bschulz1701/Project-Palmer/README.md

# Project-Palmer
Multiple system designs for golf course turf monitoring project
