bschulz1701/Project-Palmer/Documentation/2019-10-11_Project_Palmer_RectifierDesign.pdf

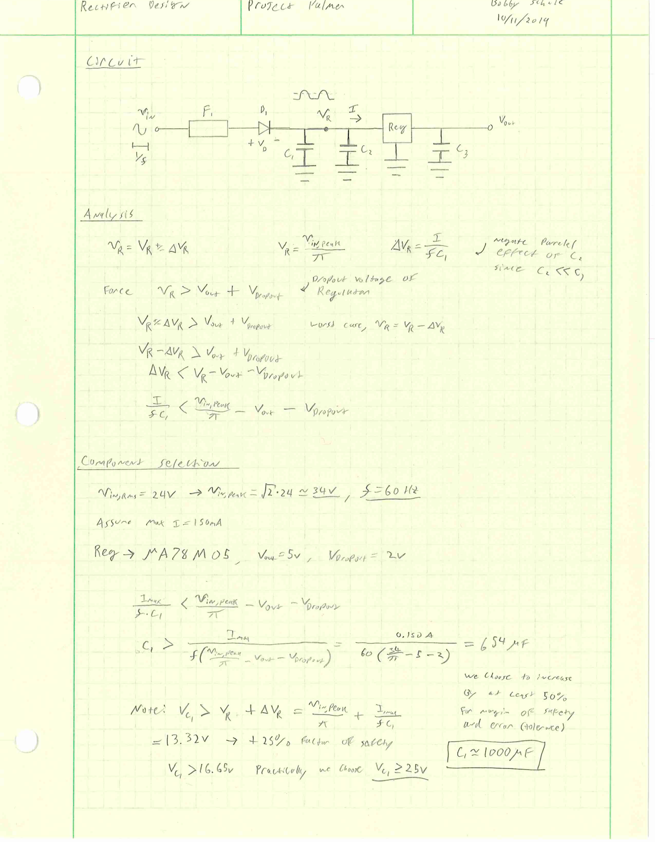
[picture p1: page 1]
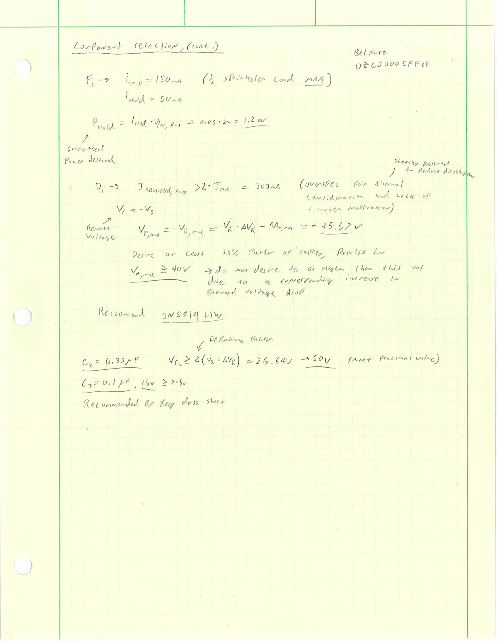
[picture p2: page 2]
