bschulz1701/Project-Palmer/Documentation/BSFrance_LoRa_32u4_Dimensions_UPDATED.pdf

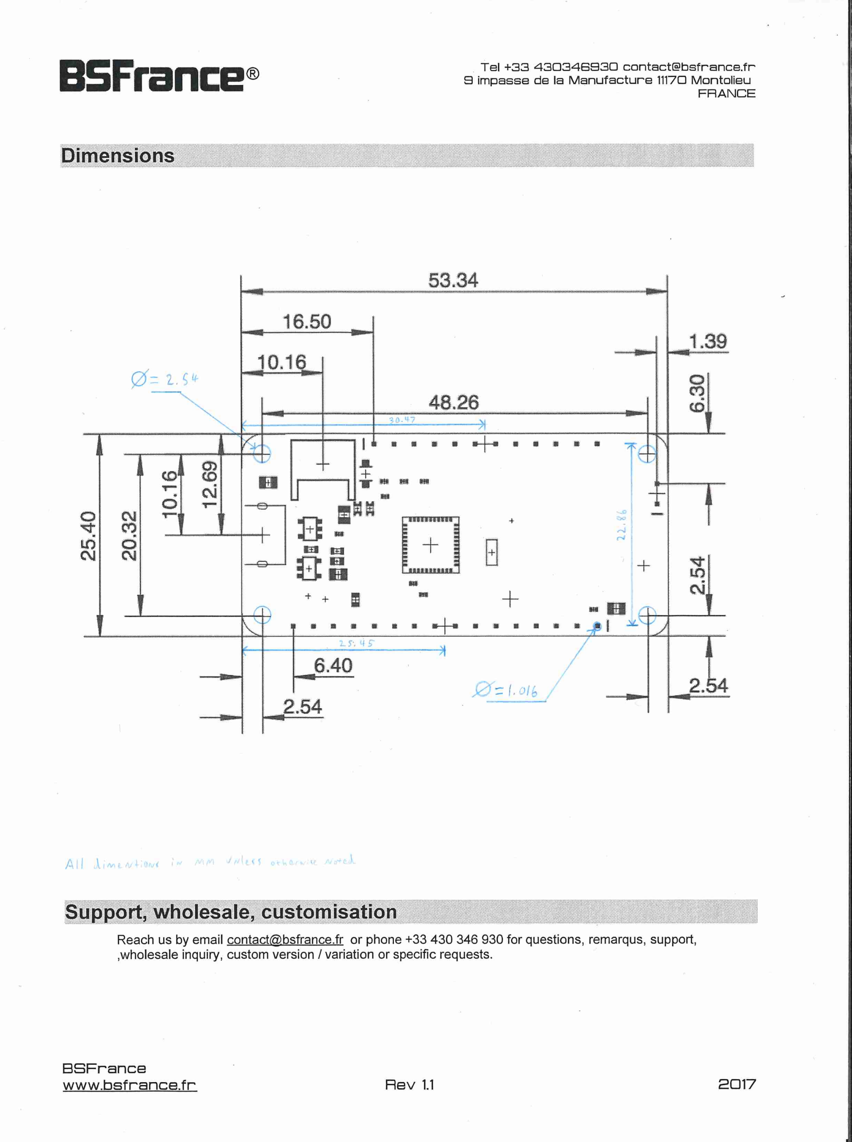
[picture p3: page 1]
