bschulz1701/Project-Palmer/Mechanical/SoilMoistureProbeHolder.SLDPRT

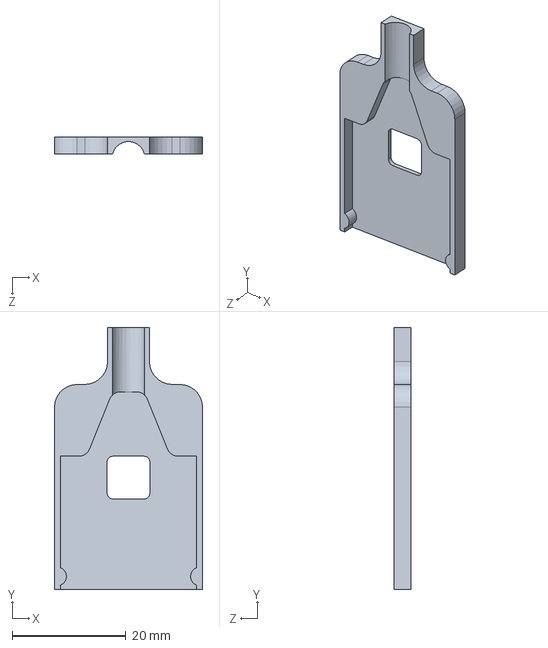
[picture p4: CAD file, 2020-04-01]
Mechanical/SoilMoistureProbeHolder.SLDPRT
26.0 x 46.0 x 3.00 mm
