bschulz1701/Project-Palmer/(list of files, cad)

Other CAD files:
Mechanical/SoilMoistureProbeHolder.STL
