bschulz1701/Project-Palmer/(threads)

Thread 1 (2019-11-12):

Change ADC Choice/Topology

bschulz1701, 2019-11-12:
## Issue:
- ADCs were placed improperly with respect to the Primary and Remote boards (they should be switched)
- MCP3221 does not have an internal reference, so should have an external reference or a tightly controlled 3.3v input rail

## Proposed Solution:
- Change ADC placement
**Correct:**
MCP3421 -> Remote Board
MCP3221 -> Primary Board
- Add voltage reference to MCP3221 circuit

### Progress:
- [ ] Change ADC arrangement
- [ ] Choose voltage reference for MCP3221
- [ ] Design circuit and implement for MCP3221

bschulz1701, 2019-11-20:
Additional design note:
Ensure ADC used on Primary Board has range up to Vcc (3.3v). **v0.0** version of system has MCP3421 on Primary Board, which has range _only up to +2.048v_, where as potential range for soil moisture sensors is up to _+Vcc (+3.3v)_. So when using the MCP3221 (with external reference) on **v0.1**, make sure external reference can allow up to +Vcc measurement.

Similarly, in **v0.1** of Remote Board, make sure the gain range of O2 amp does not exceed +2.048v

Thread 2 (2019-11-13):

Add Reset pullup

bschulz1701, 2019-11-13:
## Issue:
No pullup on `RESET` line on Primary Board, this results in problems configuring MCP23008 IO expander when no external pullup is applied (as would be the case when a LoRa 32u4 board is plugged into the corresponding socket). While this is likely to be the general operating case, it is desired to have the most flexible design possible.

## Proposed Solution:
Add 10k&Omega; pullup resistor on line

Thread 3 (2019-11-13):

PRIMARY - Add OneWire pullup

bschulz1701, 2019-11-13:
## Issue:
OneWire line needs to have a strong pull-up to work properly, which exceeds the internal pull-up available on the MCP23008 (100k&Omega;). This results in communication errors using the OneWire bus

## Proposed Solution:
Add 4.7k&Omega; pull-up to the global `ONEWIRE` line, this prevents the need for individual sensor pull-ups since this line will be connected to each via MUX when communicating

Thread 4 (2020-02-13):

REMOTE - Test TCS3400 functionality

bschulz1701, 2020-02-13:
## Issue:
TCS3400 documentation lists a minimum operating voltage of 2.7V, however, in the remote board configuration it is being run at 1.8V.

## Potential solution:
Test functionality of TCS3400 in current state (to determine validity of data), then switch system to operate at 3.3V level. Review signal routing topology to ensure desired network functionality.
