bschulz1701/Project-Palmer/Hardware/PrimaryBoard.brd

## EAGLE design Hardware/PrimaryBoard.brd (2019-10-25)

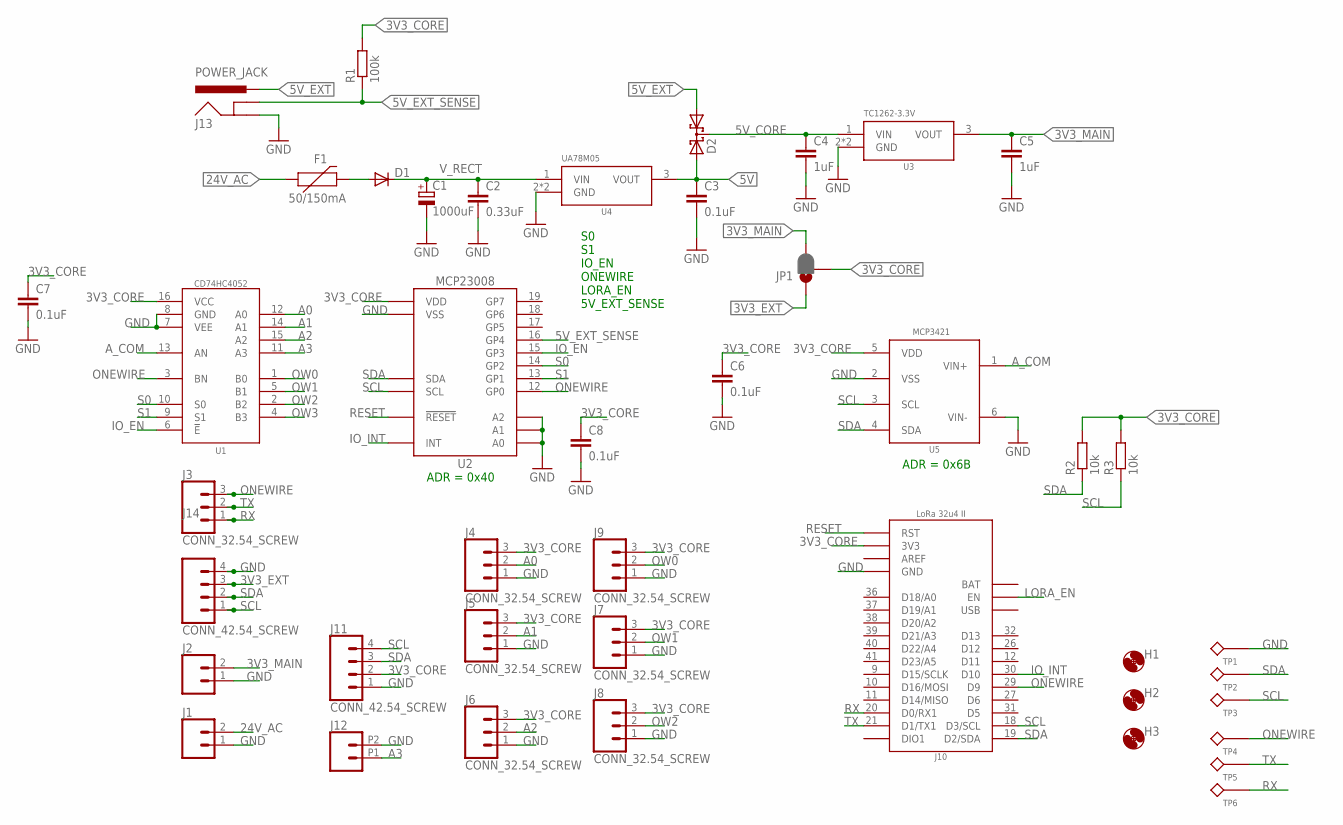
[picture p6: schematic PrimaryBoard.sch]

Parts:
C1: 1000uF; PANASONIC_G; MPN EEE-FT1E102UP; DIGIKEY P122428CT-ND
C2: 0.33uF; C0805
C3, C6, C7, C8: 0.1uF; C0805
C4, C5: 1uF; C0805
D1: DIODESOD-123; SOD-123; MPN 1N5819HW-7-F; DIGIKEY 1N5819HW-FDICT-ND
D2: DIODE_CCSDM40E20LCSOT23; SOT23-3
F1: 50/150mA; 1206
H1, H2, H3: MOUNTING_HOLE2_NP; 2_56
J1: CONN_0239532_RA; 1X02_39532_RIGHT
J2: CONN_023.5MM-NO_SILK; SCREWTERMINAL-3.5MM-2-NS
J3, J4, J5, J6, J7, J8, J9: CONN_32.54_SCREW; 1X03_SCREW
J10: LORA32U4II
J11, J14: CONN_42.54_SCREW; 1X04_SCREW
J12: CONN_022.54_SCREW; 1X02_2.54_SCREWTERM
J13: POWER_JACK; POWER_JACK_PTH
JP1: JUMPER-SMT_3_1-NC_PASTE_SILK; SMT-JUMPER_3_1-NC_PASTE_SILK
R1: 100k; R0805
R2, R3: 10k; R0805
TP1, TP2, TP3, TP4, TP5, TP6: TESTPOINTRCU; TESTPOINT_0603
U1: CD74HC4052PW; TSSOP16
U2: MCP23008SSOP; SSOP20
U3: TC1262-3.3V; SOT223
U4: UA78M05SOT223; SOT223
U5: MCP3421A3; SOT23-6L

Connections:
3V3_CORE: C6.1, C7.1, C8.1, J4.3, J5.3, J6.3, J7.3, J8.3, J9.3, J10.3V3, J11.2, JP1.2, R1.2, R2.2, R3.2, U1.16 (VCC), U2.20 (VDD), U5.5 (VDD)
3V3_EXT: J14.3, JP1.1
3V3_MAIN: C5.1, J2.2, JP1.3, U3.3 (VOUT)
5V: C3.1, D2.2 (A2), U4.3 (VOUT)
5V_CORE: C4.1, D2.3 (C), U3.1 (VIN)
5V_EXT: D2.1 (A1), J13.PWR
5V_EXT_SENSE: J13.GNDBREAK, R1.1, U2.16 (GP4)
24V_AC: F1.1, J1.2
A0: J4.2, U1.12 (A0)
A1: J5.2, U1.14 (A1)
A2: J6.2, U1.15 (A2)
A3: J12.P1 (1), U1.11 (A3)
A_COM: U1.13 (AN), U5.1 (VIN+)
BAT: J10.BAT
GND: C1.-, C2.2, C3.2, C4.2, C5.2, C6.2, C7.2, C8.2, J1.1, J2.1, J4.1, J5.1, J6.1, J7.1, J8.1, J9.1, J10.GND, J11.1, J12.P2 (2), J13.GND, J14.4, TP1.1, U1.7 (VEE), U1.8 (GND), U2.3 (A2), U2.4 (A1), U2.5 (A0), U2.9 (VSS), U3.2 (GND), U3.4 (GND), U4.2 (GND), U4.4 (GND), U5.2 (VSS), U5.6 (VIN-)
IO_EN: U1.6 (!E), U2.15 (GP3)
IO_INT: J10.30 (D10), U2.8 (INT)
LORA_EN: J10.EN
unnamed: D1.ANODE (A), F1.2
ONEWIRE: J3.3, J10.29 (D9), TP4.1, U1.3 (BN), U2.12 (GP0)
OW0: J9.2, U1.1 (B0)
OW1: J7.2, U1.5 (B1)
OW2: J8.2, U1.2 (B2)
OW3: U1.4 (B3)
RESET: J10.RST, U2.6 (!RESET)
RX: J3.1, J10.20 (D0/RX1), TP6.1
S0: U1.10 (S0), U2.14 (GP2)
S1: U1.9 (S1), U2.13 (GP1)
SCL: J10.18 (D3/SCL), J11.4, J14.1, R3.1, TP3.1, U2.1 (SCL), U5.3 (SCL)
SDA: J10.19 (D2/SDA), J11.3, J14.2, R2.1, TP2.1, U2.2 (SDA), U5.4 (SDA)
TX: J3.2, J10.21 (D1/TX1), TP5.1
USB: J10.USB
V_RECT: C1.+, C2.1, D1.CAT (C), U4.1 (VIN)

Notes on the sheet:
S0 S1 IO_EN ONEWIRE LORA_EN 5V_EXT_SENSE
ADR = 0x6B
ADR = 0x40

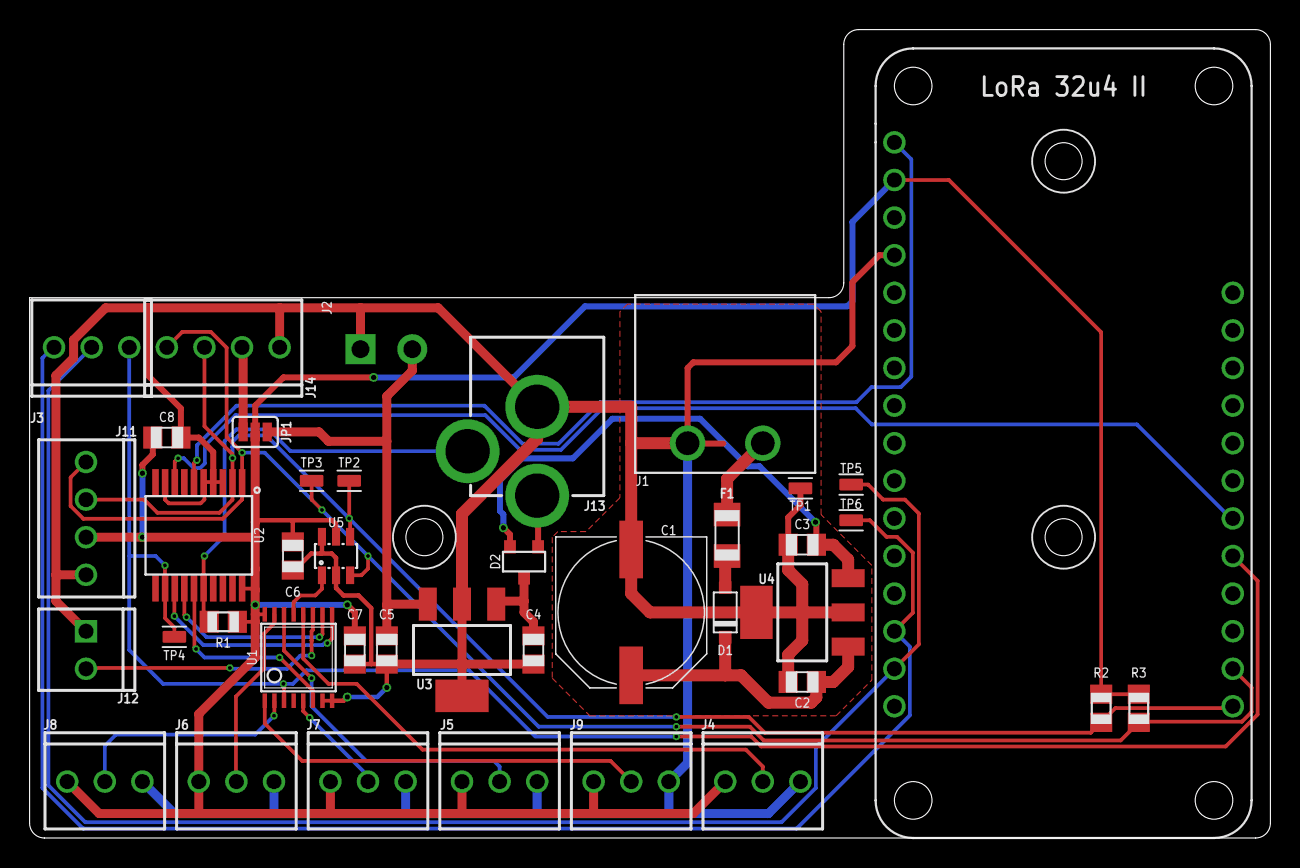
[picture p7: board PrimaryBoard.brd from above]

Board: 2 copper layers, 83.8 x 54.6 mm, 43 parts (0 on the bottom side), 29 nets.
