bschulz1701/Project-Palmer/Hardware/RemoteBoard.brd

## EAGLE design Hardware/RemoteBoard.brd (2019-10-25)

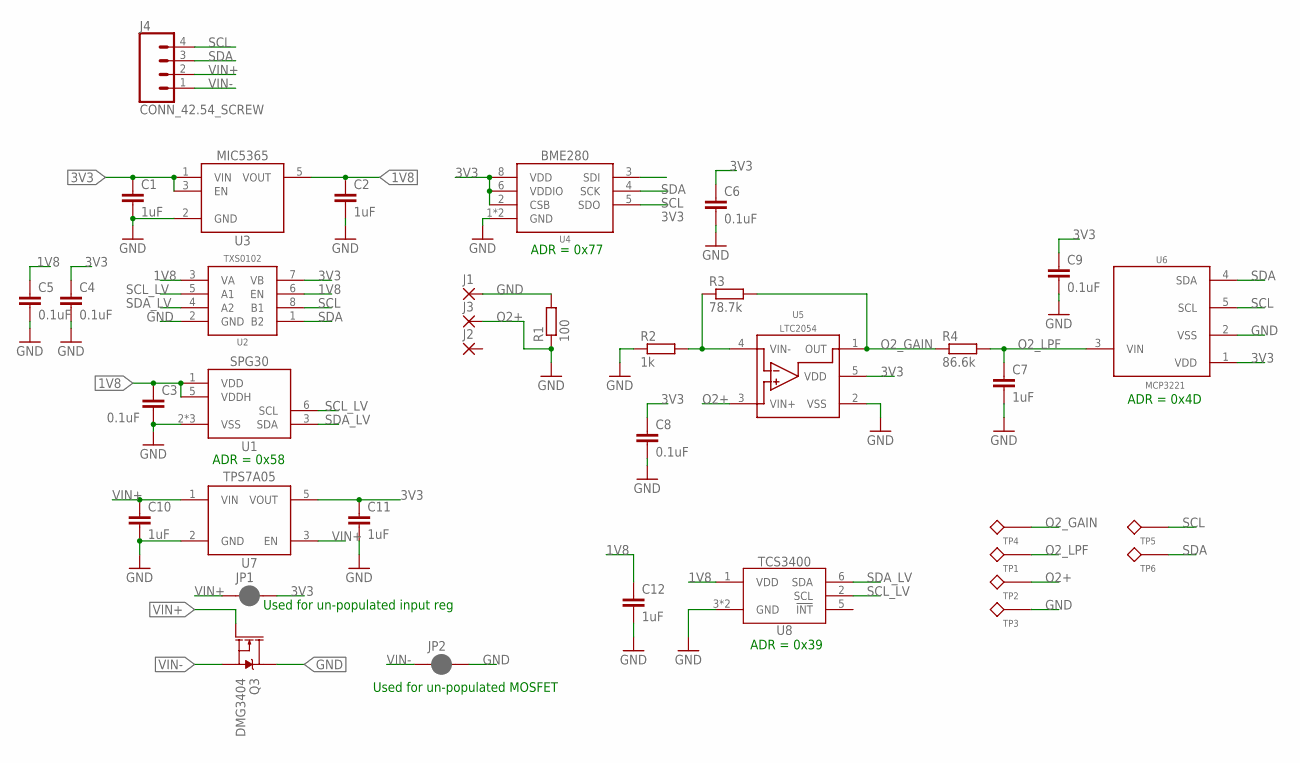
[picture p8: schematic RemoteBoard.sch]

Parts:
C1, C2, C7, C10, C11, C12: 1uF; C0805
C3, C4, C5, C6, C8, C9: 0.1uF; C0805
J1, J2, J3: SOCKETS9111_SLOT; SOCKET_S9111-45R_SLOT
J4: CONN_42.54_SCREW; 1X04_SCREW
JP1, JP2: JUMPER-SMT_2_NC_PASTE_SILK; SMT-JUMPER_2_NC_PASTE_SILK
Q3: DMG3404; SOT23-3
R1: 100; R0805
R2: 1k; R0805
R3: 78.7k; R0805
R4: 86.6k; R0805
TP1, TP2, TP3, TP4, TP5, TP6: TESTPOINTRCU; TESTPOINT_0603
U1: SPG30; DFN_6_2.5X2.5
U2: TXS0102DCU; DCU_(R-PDSO-G8)
U3: MIC53651.8SC70; DCK_R-PDSO-G5
U4: BME280
U5: LTC2054; SOT23-5
U6: MCP3221; SOT23-5
U7: TPS7A0533DBV; SOT23-5
U8: TCS3400

Connections:
1V8: C2.1, C3.1, C5.1, C12.1, U1.1 (VDD), U1.5 (VDDH), U2.3 (VA), U2.6 (EN), U3.5 (VOUT), U8.1 (VDD)
3V3: C1.1, C4.1, C6.1, C8.1, C9.1, C11.1, JP1.2, U2.7 (VB), U3.1 (VIN), U3.3 (EN), U4.2 (CSB), U4.5 (SDO), U4.6 (VDDIO), U4.8 (VDD), U5.5 (VDD), U6.1 (VDD), U7.5 (VOUT)
GND: C1.2, C2.2, C3.2, C4.2, C5.2, C6.2, C7.2, C8.2, C9.2, C10.2, C11.2, C12.2, J1.PAD, JP2.2, Q3.3 (D), R1.2, R2.1, TP3.1, U1.2 (VSS), U1.4 (VSS), U1.EP (VSS), U2.2 (GND), U3.2 (GND), U4.1 (GND), U4.7 (GND), U5.2 (VSS), U6.2 (VSS), U7.2 (GND), U8.3 (GND), U8.4 (GND)
unnamed: R2.2, R3.1, U5.4 (VIN-)
O2+: J3.PAD, R1.1, TP2.1, U5.3 (VIN+)
O2_GAIN: R3.2, R4.1, TP4.1, U5.1 (OUT)
O2_LPF: C7.1, R4.2, TP1.1, U6.3 (VIN)
SCL: J4.4, TP5.1, U2.8 (B1), U4.4 (SCK), U6.5 (SCL)
SCL_LV: U1.6 (SCL), U2.5 (A1), U8.2 (SCL)
SDA: J4.3, TP6.1, U2.1 (B2), U4.3 (SDI), U6.4 (SDA)
SDA_LV: U1.3 (SDA), U2.4 (A2), U8.6 (SDA)
VIN+: C10.1, J4.2, JP1.1, Q3.1 (G), U7.1 (VIN), U7.3 (EN)
VIN-: J4.1, JP2.1, Q3.2 (S)

Notes on the sheet:
Used for un-populated MOSFET
Used for un-populated input reg
ADR = 0x4D
ADR = 0x58
ADR = 0x77
ADR = 0x39

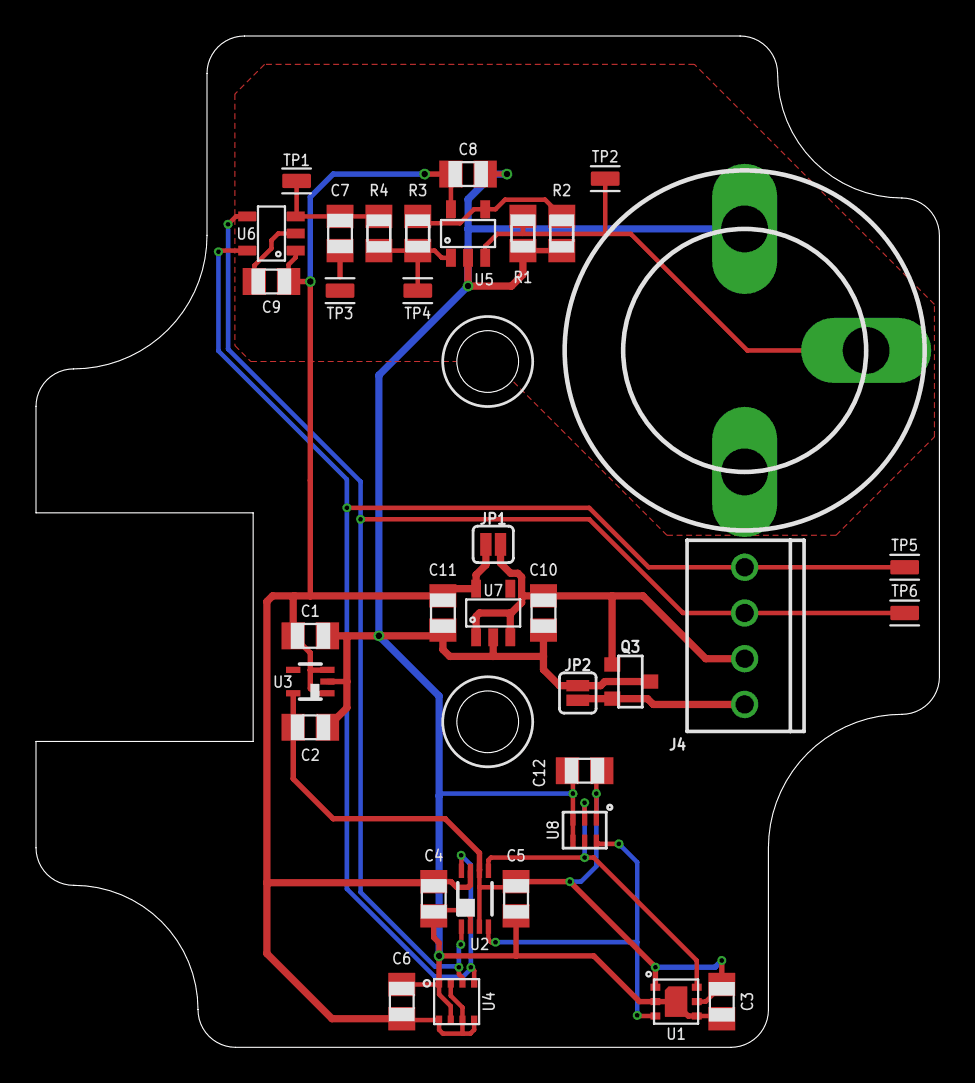
[picture p9: board RemoteBoard.brd from above]

Board: 2 copper layers, 50.2 x 56.2 mm, 37 parts (0 on the bottom side), 13 nets.
