bschulz1701/Project-Palmer/(commit log)

2019-10-15 Added spectral response data
    Added extracted spectral response data to compare TCS3200 and TCS3400
    [TCS3200_Response.csv, TCS3400_Response.csv]
2019-10-16 Preliminary Primary Board CAD
    Preliminary schematic entry and board layout
    [PrimaryBoard.brd, PrimaryBoard.sch]
2019-10-17 Beginning schematic capture for Remote Board
    [RemoteBoard.sch]
2019-10-18 Minor updates and cleanup for primary board
    [PrimaryBoard.brd, PrimaryBoard.sch]
2019-10-18 Continued schematic capture for remote board, layout begin
    Schematic for remote board complete except for TCS3400, significant layout progress
    [RemoteBoard.brd, RemoteBoard.sch]
2019-10-21 Minor updates to Primary and Remote
    Cleaned up/added silkscreen, added test points to both boards
    [PrimaryBoard.brd, PrimaryBoard.sch, RemoteBoard.brd, RemoteBoard.sch]
2019-10-24 Added matlab data O2 sensor test analysis
2019-10-24 Minor cleanup/fixes to boards, generated gerbers
    Minor changes to boards, primarily cleanup and generated gerbers for fab, ready for review
    [PrimaryBoard.brd, PrimaryBoard.sch, RemoteBoard.brd, RemoteBoard.sch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]
2019-10-25 Minor updates, part vals
    Changed 1x7 connector on Primary board to 1x4 and 1x3 because 1x7 0.1" screw terminals are made of Corinthian Leather apparently, also updated part values and BoM vals
    [PrimaryBoard.brd, PrimaryBoard.sch, RemoteBoard.brd, RemoteBoard.sch]
2019-10-25 Generated BoM for both boards
    [PrimaryBoard_BoM.csv, RemoteBoard_BoM.csv]
2019-11-13 Updated repo folder structure
    [PrimaryBoard.brd, PrimaryBoard.sch, PrimaryBoard_BoM.csv, RemoteBoard.brd, RemoteBoard.sch, RemoteBoard_BoM.csv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]
2019-11-13 Fixed #ifdef in combo demo
    [Palmer_Combo_Demo.ino]
2019-11-20 Cleanup/Minor updates to logging code
    Added comment descriptor, updated ifdef system to allow for echoing LoRa transmission to serial monitor, changed the format of serial print to be echo of LoRa string instead of new line style, changed update rate to be variable while instead of fixed delay (exactly 1 second between readings), changed auto-range to only run every baseline update, added option to print error flags, general cleanup
    [LoRa_Node_BETA.ino]
2019-11-21 Fixed LoRa config issue, added support for hardware serial output
    Added support for hardware serial output to support use of openlog, fixed LoRa configuration issue
    [LoRa_Node_BETA.ino]
2019-11-23 Added designs for soil moisture holders
    Added mechanical designs for soil moisture probe holders (for 3D printing)
    [SoilMoistureProbeHolder.SLDPRT, SoilMoistureProbeHolder.STL]
2019-12-09 Added drill guide PDF for box
2020-04-01 Updated folder structure, readme, and git lfs issues
    Updated PDFs and other files to be free of git lfs, updated readme, added main data sheets
    [SoilMoistureProbeHolder.SLDPRT, SoilMoistureProbeHolder.STL, TCS3200_Response.csv, TCS3400_Response.csv]
2020-04-01 Removed erroneous GND symbol
    [RemoteBoard.sch]
